leanofis-iot/th/eagle/th/th.brd

## EAGLE design eagle/th/th.brd (2020-03-03)

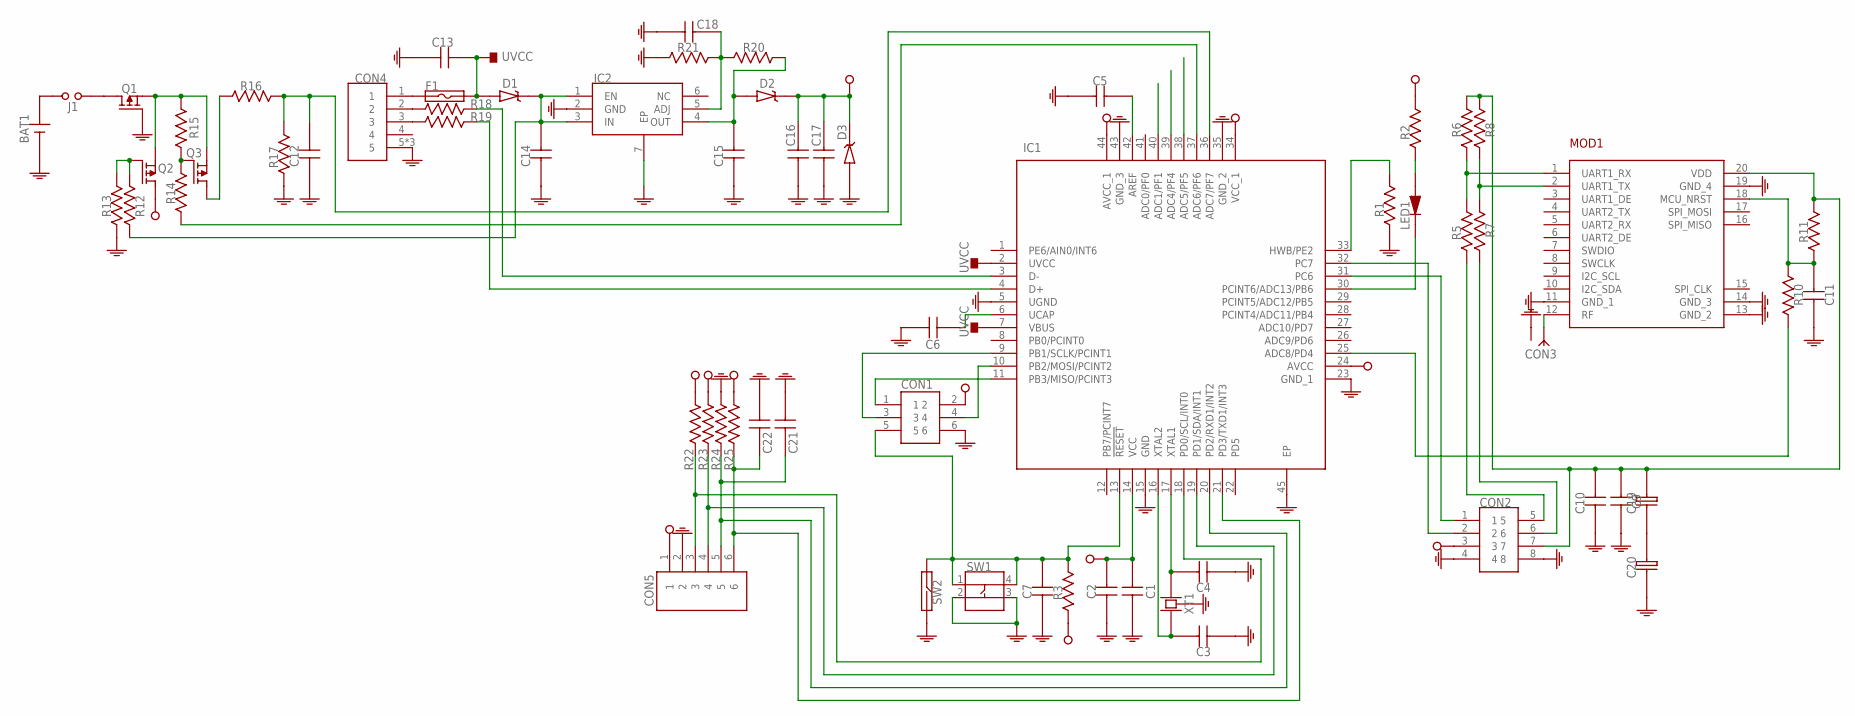
[picture p1: schematic th.sch]

Parts:
BAT1: 211P-C-HOLDER
C1, C2, C3, C4, C5, C6, C7, C9, C10, C11, C12, C13, C16, C17, C18, C21, C22: CAPACITOR-0603; 0603
C14, C15: CAPACITOR-0805; 0805
C19, C20: CAPACITOR-8-3.5
CON1: ISP
CON2: HEADER-8P-2R-DIP-2_54MM
CON3: SMA-RF
CON4: USB-MICRO-DIP-VER
CON5: HEADER-6P-DIP-2_54MM
D1, D2: DIODE-SCHOTTKY; SOD123-DIODE
D3: ZENER-SOD123; SOD123-DIODE
F1: FUSE-1206; 1206
IC1: ATMEGA32U4-MU; QFN-44
IC2: MIC5219-ADJ-TDFN-6; TDFN-6
J1: JUMPER; HEADER-2P-DIP-2_54MM
LED1: LED-0805; 0805-LED
MOD1: RAK4200
Q1, Q2, Q3: P-MOSFET; SOT23-3
R1, R2, R3, R5, R6, R7, R8, R10, R11, R12, R13, R14, R15, R16, R17, R18, R19, R20, R21, R22, R23, R24, R25: RESISTOR-0603; 0603
SW1: BUTTON-4P-SMD-5X5
SW2: REED-DIP
XT1: CRYSTAL-5032-4P

Connections:
GND: BAT1.2 (-), C1.1, C2.1, C3.1, C4.1, C5.1, C6.1, C7.1, C9.1, C10.1, C11.1, C12.1, C13.1, C14.1, C15.1, C16.1, C17.1, C18.1, C20.P$1 (1), C21.1, C22.1, CON1.6, CON2.4, CON2.8, CON3.2 (GND), CON3.3 (GND), CON3.4 (GND), CON3.5 (GND), CON4.5, CON4.6 (5), CON4.7 (5), CON5.2, D3.2 (A), IC1.5 (UGND), IC1.15 (GND), IC1.23 (GND_1), IC1.35 (GND_2), IC1.43 (GND_3), IC1.45 (EP), IC2.2 (GND), IC2.7 (EP), MOD1.11 (GND_1), MOD1.13 (GND_2), MOD1.14 (GND_3), MOD1.19 (GND_4), Q1.1 (G), R1.1, R13.1, R17.1, R21.1, R24.1, SW1.2, SW1.3, SW2.P$2 (2), XT1.2 (GND), XT1.4 (GND)
unnamed: C7.2, CON1.5, IC1.13 (!RESET), R3.2, SW1.1, SW1.4, SW2.P$1 (1)
unnamed: C11.2, MOD1.18 (MCU_NRST), R10.1, R11.1
unnamed: CON1.1, IC1.11 (PB3/MISO/PCINT3)
unnamed: CON3.1 (ANT), MOD1.12 (RF)
unnamed: J1.1, Q1.3 (D)
unnamed: MOD1.1 (UART1_RX), R5.2, R6.1
unnamed: MOD1.2 (UART1_TX), R7.2, R8.1
unnamed: BAT1.1 (+), J1.2 (3)
unnamed: CON1.4, IC1.10 (PB2/MOSI/PCINT2)
unnamed: C3.2, IC1.16 (XTAL2), XT1.1
unnamed: CON2.1, IC1.31 (PC6)
unnamed: C4.2, IC1.17 (XTAL1), XT1.3 (2)
unnamed: C9.2, C10.2, C19.P$2 (2), CON2.7, MOD1.20 (VDD), R6.2, R8.2, R11.2
unnamed: CON2.6, R7.1
unnamed: C18.2, IC2.5 (ADJ), R20.2, R21.2
unnamed: IC1.25 (ADC8/PD4), R10.2
unnamed: C21.2, CON5.5, IC1.20 (PD2/RXD1/INT2), R24.2
unnamed: C22.2, CON5.6, IC1.21 (PD3/TXD1/INT3), R25.2
unnamed: IC1.30 (PCINT6/ADC13/PB6), LED1.1 (K)
unnamed: C19.P$1 (1), C20.P$2 (2)
unnamed: CON2.2, IC1.32 (PC7)
unnamed: C5.2, IC1.42 (AREF)
unnamed: Q3.1 (G), R14.2, R15.2
unnamed: CON4.1, F1.1
unnamed: C6.2, IC1.6 (UCAP)
unnamed: LED1.2 (A), R2.1
unnamed: C12.2, IC1.36 (ADC7/PF7), R16.2, R17.2
unnamed: C14.2, D1.1 (K), IC2.1 (EN), IC2.3 (IN), R12.1
unnamed: C15.2, D2.2 (A), IC2.4 (OUT), R20.1
unnamed: CON4.2, R18.1
unnamed: CON4.3, R19.1
unnamed: IC1.3 (D-), R18.2
unnamed: IC1.4 (D+), R19.2
unnamed: CON1.3, IC1.9 (PB1/SCLK/PCINT1)
unnamed: IC1.37 (ADC6/PF6), R14.1
unnamed: Q2.1 (G), R12.2, R13.2
unnamed: Q1.2 (S), Q2.2 (S), Q3.2 (S), R15.1
unnamed: Q3.3 (D), R16.1
unnamed: CON2.5, R5.1
unnamed: IC1.33 (HWB/PE2), R1.2
unnamed: CON5.3, IC1.18 (PD0/SCL/INT0), R22.2
unnamed: CON5.4, IC1.19 (PD1/SDA/INT1), R23.2
UVCC: C13.2, D1.2 (A), F1.2, IC1.2 (UVCC), IC1.7 (VBUS)
VCC: C1.2, C2.2, C16.2, C17.2, CON1.2, CON2.3, CON5.1, D2.1 (K), D3.1 (K), IC1.14 (VCC), IC1.24 (AVCC), IC1.34 (VCC_1), IC1.44 (AVCC_1), Q2.3 (D), R2.2, R3.1, R22.1, R23.1, R25.1

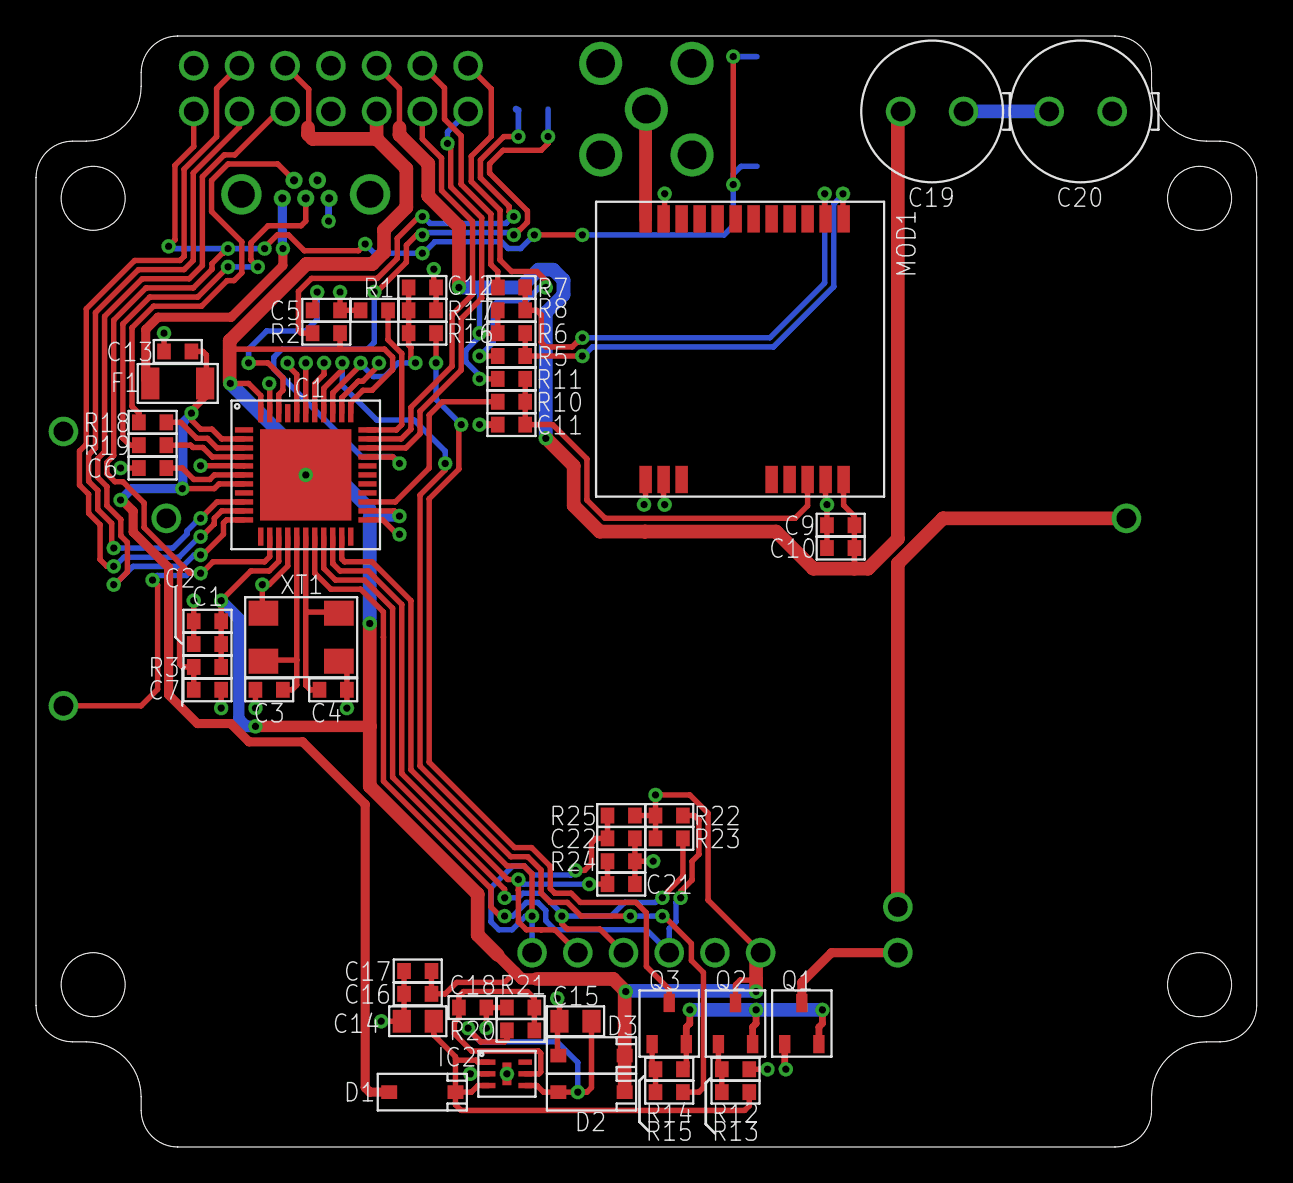
[picture p2: board th.brd from above]

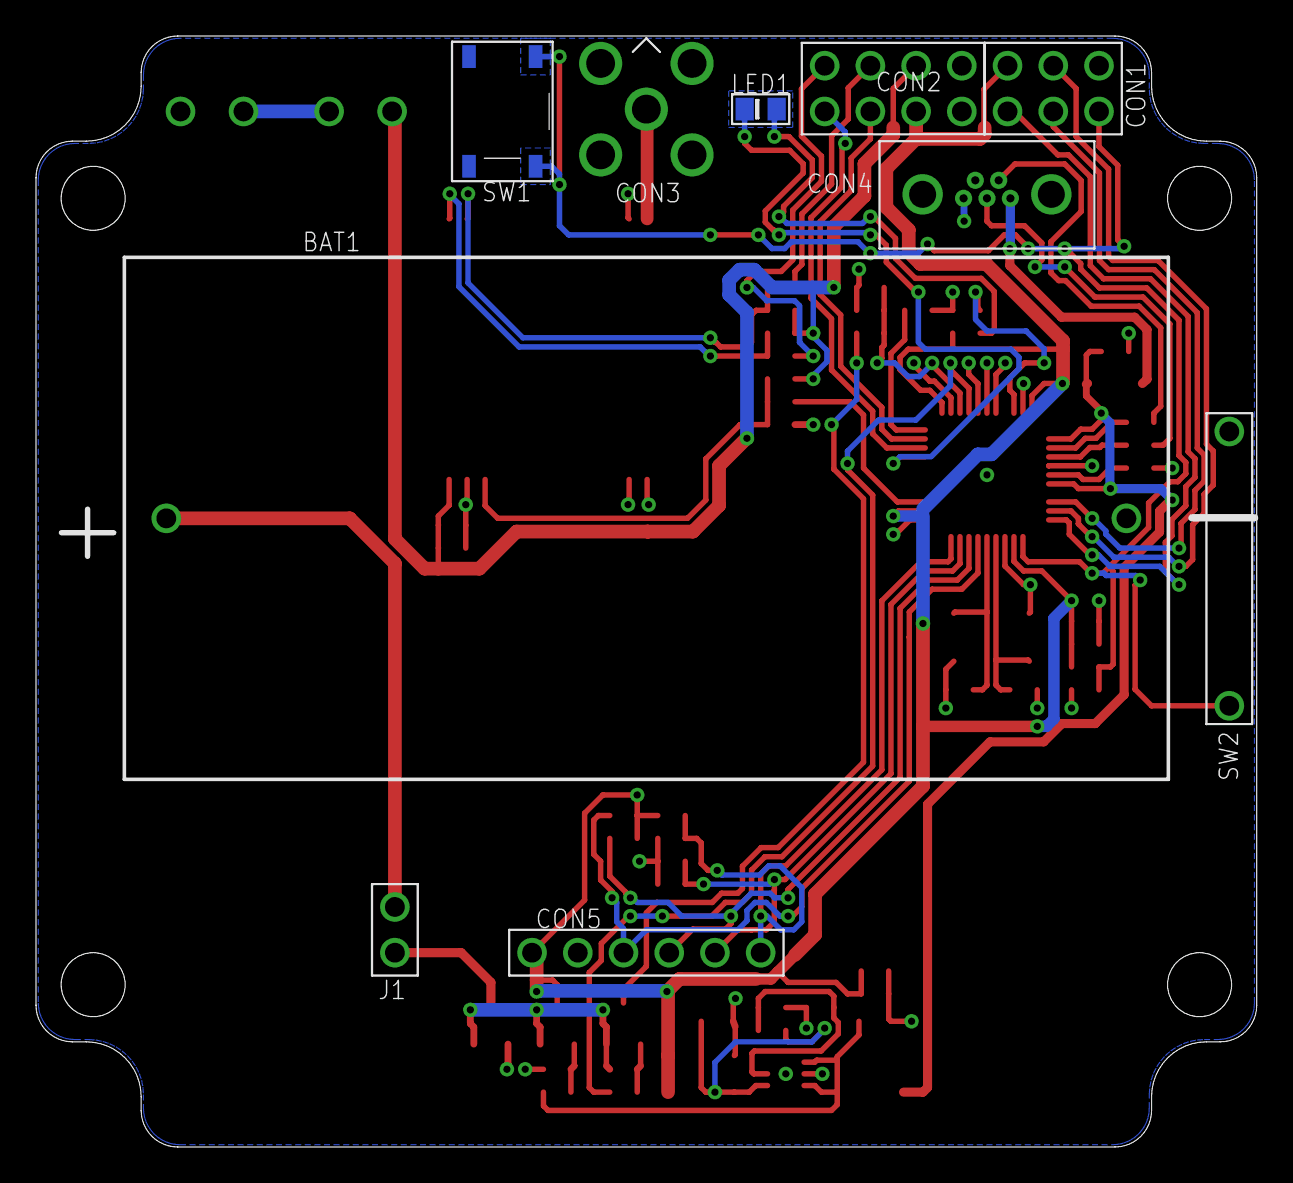
[picture p3: board th.brd from below]

Board: 2 copper layers, 67.8 x 61.7 mm, 65 parts (10 on the bottom side), 45 nets.
